veekshita117/Audio-Amplifier-Design/Circuit/PREAMPLIFIER.asc

Q1: npn; BC547B
Q2: npn; BC547B
R1: res; 2k
R2: res; 2k
R3: res; 8k
V1: voltage; -5
V2: voltage; 5
V3: voltage; SINE(0 10m 15k)
V4: voltage; SINE(0 -10m 15k)
Named nets: 0
.tran 10m
