veekshita117/Audio-Amplifier-Design/Circuit/POWERAMPLIFIER.asc

C1: cap; 10µ
C2: cap; 10µ
Q1: npn; Qtip31a
Q2: pnp; Qtip32a
R1: res; 1.5k
R2: res; 1.5k
R3: res; 2k
R4: res; 2k
R5: res; 10
V1: voltage; SINE(0 4.34 15k)
V2: voltage; 5
V3: voltage; -5
Named nets: 0
.include tip31a.lib
.include tip32a.lib
.tran 10m
