veekshita117/Audio-Amplifier-Design/Circuit/GAIN.asc

C1: cap; 500n
C2: cap; 10µ
C3: cap; 20n
Q1: npn; BC547B
R1: res; 15k
R2: res; 1k
R3: res; 100k
R4: res; 10k
V1: voltage; SINE(0 160m 15k)
V2: voltage; -5
V3: voltage; 5
Named nets: 0
.tran 10m
