veekshita117/Audio-Amplifier-Design/Circuit/FINAL.asc

C1: cap; 500n
C2: cap; 20n
C3: cap; 10µ
C4: cap; 100n
C5: cap; 2.2p
C6: cap; 10µ
C7: cap; 10µ
D1: diode; 1N4148
D2: diode; 1N4148
Q1: npn; BC547B
Q2: npn; BC547B
Q3: npn; BC547B
Q4: npn; Qtip31a
Q5: pnp; Qtip32a
R1: res; 2k
R2: res; 2k
R3: res; 8k
R4: res; 100k
R5: res; 10k
R6: res; 15k
R7: res; 1k
R8: res; 500k
R9: res; 515k
R12: res; 2k
R13: res; 2k
R14: res; 10
U1: opamp2; UA741
V1: voltage; 5
V2: voltage; -5
V3: voltage; SINE(0 10m 15k)
V4: voltage; SINE(0 -10m 15k)
V5: voltage; 5
V6: voltage; -5
V7: voltage; 12
V8: voltage; -12
V9: voltage; 5
V10: voltage; -5
Named nets: 0
.include UA741.lib
.include tip31a.lib
.include tip32a.lib
.tran 10m
