veekshita117/Audio-Amplifier-Design/Circuit/FILTER.asc

C1: cap; 2.2p
C2: cap; 100n
R1: res; 515K
R2: res; 500k
U1: opamp2; UA741
V1: voltage; 12
V2: voltage; -12
V3: voltage; SINE(0 4.26 15k)
Named nets: 0
.include UA741.lib
.tran 10m
