veekshita117/Audio-Amplifier-Design/(commit log)

2026-09-26 Add filter circuit design
2026-09-26 Add final amplifier circuit
2026-09-26 Add amplifier gain circuit
2026-09-26 Add power amplifier circuit
2026-09-26 Add preamplifier circuit
2026-09-26 Add component bill of materials
